zertechleba/minigraf-0507-arduino/docs/img/schema_xy4131_en.jpg

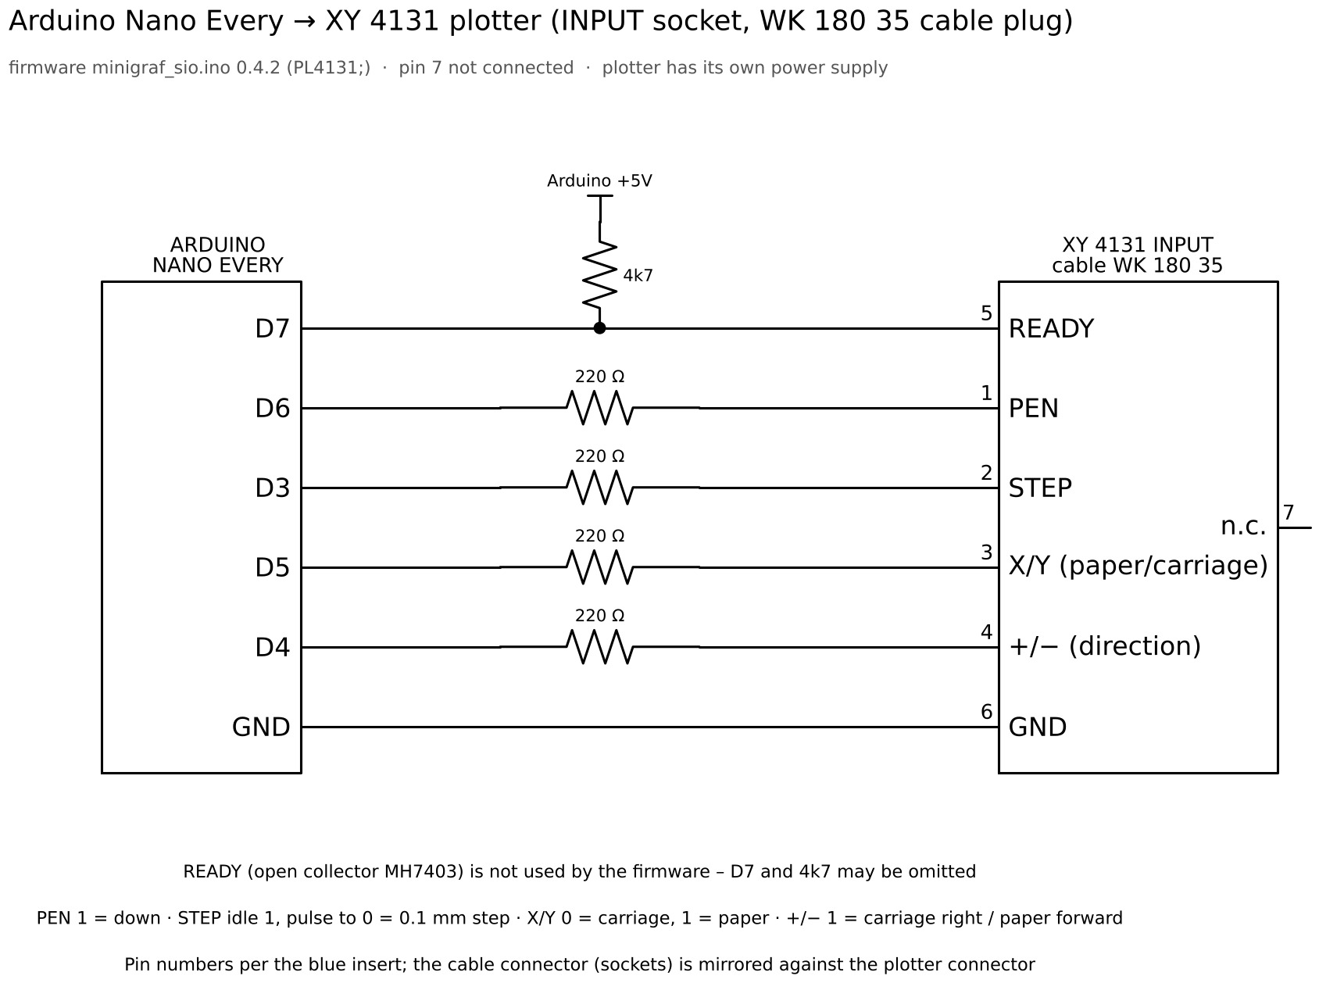
docs/img/schema_xy4131_en.jpg
