zertechleba/minigraf-0507-arduino/pc/hershey_script.py

"""Hersheyho jednotahové psací písmo "cursive" (A. V. Hershey, U.S. National Bureau of Standards, 1967):
písmena psacího písma "scripts", číslice a znaménka jednou čarou.
Data převzata z balíčku HersheyFonts (https://github.com/apshu/HersheyFonts, licence MIT).
Formát: znak -> (levý okraj, pravý okraj, tahy); souřadnice Hershey: y dolů, účaří y = 9,
horní linie velkých písmen y = -12. Převod a diakritiku dělá text_plot.py (--font psane)."""

GLYPHS = {
    ' ': (-8, 8, []),
    '!': (-5, 5, [[(0, -12), (0, 2)], [(0, 7), (-1, 8), (0, 9), (1, 8), (0, 7)]]),
    '"': (-8, 8, [[(-4, -12), (-4, -5)], [(4, -12), (4, -5)]]),
    '#': (-10, 11, [[(1, -16), (-6, 16)], [(7, -16), (0, 16)], [(-6, -3), (8, -3)], [(-7, 3), (7, 3)]]),
    '$': (-10, 10, [[(-2, -16), (-2, 13)], [(2, -16), (2, 13)], [(7, -9), (5, -11), (2, -12), (-2, -12), (-5, -11), (-7, -9), (-7, -7), (-6, -5), (-5, -4), (-3, -3), (3, -1), (5, 0), (6, 1), (7, 3), (7, 6), (5, 8), (2, 9), (-2, 9), (-5, 8), (-7, 6)]]),
    '%': (-12, 12, [[(9, -12), (-9, 9)], [(-4, -12), (-2, -10), (-2, -8), (-3, -6), (-5, -5), (-7, -5), (-9, -7), (-9, -9), (-8, -11), (-6, -12), (-4, -12), (-2, -11), (1, -10), (4, -10), (7, -11), (9, -12)], [(5, 2), (3, 3), (2, 5), (2, 7), (4, 9), (6, 9), (8, 8), (9, 6), (9, 4), (7, 2), (5, 2)]]),
    '&': (-13, 13, [[(10, -3), (10, -4), (9, -5), (8, -5), (7, -4), (6, -2), (4, 3), (2, 6), (0, 8), (-2, 9), (-6, 9), (-8, 8), (-9, 7), (-10, 5), (-10, 3), (-9, 1), (-8, 0), (-1, -4), (0, -5), (1, -7), (1, -9), (0, -11), (-2, -12), (-4, -11), (-5, -9), (-5, -7), (-4, -4), (-2, -1), (3, 6), (5, 8), (7, 9), (9, 9), (10, 8), (10, 7)]]),
    "'": (-2, 2, [[(0, -5), (0, -1)]]),
    '(': (-7, 7, [[(4, -16), (2, -14), (0, -11), (-2, -7), (-3, -2), (-3, 2), (-2, 7), (0, 11), (2, 14), (4, 16)]]),
    ')': (-7, 7, [[(-4, -16), (-2, -14), (0, -11), (2, -7), (3, -2), (3, 2), (2, 7), (0, 11), (-2, 14), (-4, 16)]]),
    '*': (-8, 8, [[(0, -6), (0, 6)], [(-5, -3), (5, 3)], [(5, -3), (-5, 3)]]),
    '+': (-13, 13, [[(0, -9), (0, 9)], [(-9, 0), (9, 0)]]),
    ',': (-4, 4, [[(1, 5), (0, 6), (-1, 5), (0, 4), (1, 5), (1, 7), (-1, 9)]]),
    '-': (-13, 13, [[(-9, 0), (9, 0)]]),
    '.': (-4, 4, [[(0, 4), (-1, 5), (0, 6), (1, 5), (0, 4)]]),
    '/': (-11, 11, [[(9, -16), (-9, 16)]]),
    '0': (-10, 10, [[(-1, -12), (-4, -11), (-6, -8), (-7, -3), (-7, 0), (-6, 5), (-4, 8), (-1, 9), (1, 9), (4, 8), (6, 5), (7, 0), (7, -3), (6, -8), (4, -11), (1, -12), (-1, -12)]]),
    '1': (-10, 10, [[(-4, -8), (-2, -9), (1, -12), (1, 9)]]),
    '2': (-10, 10, [[(-6, -7), (-6, -8), (-5, -10), (-4, -11), (-2, -12), (2, -12), (4, -11), (5, -10), (6, -8), (6, -6), (5, -4), (3, -1), (-7, 9), (7, 9)]]),
    '3': (-10, 10, [[(-5, -12), (6, -12), (0, -4), (3, -4), (5, -3), (6, -2), (7, 1), (7, 3), (6, 6), (4, 8), (1, 9), (-2, 9), (-5, 8), (-6, 7), (-7, 5)]]),
    '4': (-10, 10, [[(3, -12), (-7, 2), (8, 2)], [(3, -12), (3, 9)]]),
    '5': (-10, 10, [[(5, -12), (-5, -12), (-6, -3), (-5, -4), (-2, -5), (1, -5), (4, -4), (6, -2), (7, 1), (7, 3), (6, 6), (4, 8), (1, 9), (-2, 9), (-5, 8), (-6, 7), (-7, 5)]]),
    '6': (-10, 10, [[(6, -9), (5, -11), (2, -12), (0, -12), (-3, -11), (-5, -8), (-6, -3), (-6, 2), (-5, 6), (-3, 8), (0, 9), (1, 9), (4, 8), (6, 6), (7, 3), (7, 2), (6, -1), (4, -3), (1, -4), (0, -4), (-3, -3), (-5, -1), (-6, 2)]]),
    '7': (-10, 10, [[(7, -12), (-3, 9)], [(-7, -12), (7, -12)]]),
    '8': (-10, 10, [[(-2, -12), (-5, -11), (-6, -9), (-6, -7), (-5, -5), (-3, -4), (1, -3), (4, -2), (6, 0), (7, 2), (7, 5), (6, 7), (5, 8), (2, 9), (-2, 9), (-5, 8), (-6, 7), (-7, 5), (-7, 2), (-6, 0), (-4, -2), (-1, -3), (3, -4), (5, -5), (6, -7), (6, -9), (5, -11), (2, -12), (-2, -12)]]),
    '9': (-10, 10, [[(6, -5), (5, -2), (3, 0), (0, 1), (-1, 1), (-4, 0), (-6, -2), (-7, -5), (-7, -6), (-6, -9), (-4, -11), (-1, -12), (0, -12), (3, -11), (5, -9), (6, -5), (6, 0), (5, 5), (3, 8), (0, 9), (-2, 9), (-5, 8), (-6, 6)]]),
    ':': (-4, 4, [[(0, -3), (-1, -2), (0, -1), (1, -2), (0, -3)], [(0, 4), (-1, 5), (0, 6), (1, 5), (0, 4)]]),
    ';': (-4, 4, [[(0, -3), (-1, -2), (0, -1), (1, -2), (0, -3)], [(1, 5), (0, 6), (-1, 5), (0, 4), (1, 5), (1, 7), (-1, 9)]]),
    '<': (-12, 12, [[(8, -9), (-8, 0), (8, 9)]]),
    '=': (-13, 13, [[(-9, -3), (9, -3)], [(-9, 3), (9, 3)]]),
    '>': (-12, 12, [[(-8, -9), (8, 0), (-8, 9)]]),
    '?': (-9, 9, [[(-6, -7), (-6, -8), (-5, -10), (-4, -11), (-2, -12), (2, -12), (4, -11), (5, -10), (6, -8), (6, -6), (5, -4), (4, -3), (0, -1), (0, 2)], [(0, 7), (-1, 8), (0, 9), (1, 8), (0, 7)]]),
    '@': (-13, 14, [[(5, -4), (4, -6), (2, -7), (-1, -7), (-3, -6), (-4, -5), (-5, -2), (-5, 1), (-4, 3), (-2, 4), (1, 4), (3, 3), (4, 1)], [(-1, -7), (-3, -5), (-4, -2), (-4, 1), (-3, 3), (-2, 4)], [(5, -7), (4, 1), (4, 3), (6, 4), (8, 4), (10, 2), (11, -1), (11, -3), (10, -6), (9, -8), (7, -10), (5, -11), (2, -12), (-1, -12), (-4, -11), (-6, -10), (-8, -8), (-9, -6), (-10, -3), (-10, 0), (-9, 3), (-8, 5), (-6, 7), (-4, 8), (-1, 9), (2, 9), (5, 8), (7, 7), (8, 6)], [(6, -7), (5, 1), (5, 3), (6, 4)]]),
    'A': (-11, 9, [[(-11, 9), (-9, 8), (-6, 5), (-3, 1), (1, -6), (4, -12), (4, 9), (3, 6), (1, 3), (-1, 1), (-4, -1), (-6, -1), (-7, 0), (-7, 2), (-6, 4), (-4, 6), (-1, 8), (2, 9), (7, 9)]]),
    'B': (-12, 11, [[(1, -10), (2, -9), (2, -6), (1, -2), (0, 1), (-1, 3), (-3, 6), (-5, 8), (-7, 9), (-8, 9), (-9, 8), (-9, 5), (-8, 0), (-7, -3), (-6, -5), (-4, -8), (-2, -10), (0, -11), (3, -12), (6, -12), (8, -11), (9, -9), (9, -7), (8, -5), (7, -4), (5, -3), (2, -2)], [(1, -2), (2, -2), (5, -1), (6, 0), (7, 2), (7, 5), (6, 7), (5, 8), (3, 9), (0, 9), (-2, 8), (-3, 6)]]),
    'C': (-10, 10, [[(2, -6), (2, -5), (3, -4), (5, -4), (7, -5), (8, -7), (8, -9), (7, -11), (5, -12), (2, -12), (-1, -11), (-3, -9), (-5, -6), (-6, -4), (-7, 0), (-7, 4), (-6, 7), (-5, 8), (-3, 9), (-1, 9), (2, 8), (4, 6), (5, 4)]]),
    'D': (-11, 12, [[(2, -12), (0, -11), (-1, -9), (-2, -5), (-3, 1), (-4, 4), (-5, 6), (-7, 8), (-9, 9), (-11, 9), (-12, 8), (-12, 6), (-11, 5), (-9, 5), (-7, 6), (-5, 8), (-2, 9), (1, 9), (4, 8), (6, 6), (8, 2), (9, -3), (9, -7), (8, -10), (7, -11), (5, -12), (2, -12), (0, -10), (0, -8), (1, -5), (3, -2), (5, 0), (8, 2), (10, 3)]]),
    'E': (-10, 10, [[(4, -8), (4, -7), (5, -6), (7, -6), (8, -7), (8, -9), (7, -11), (4, -12), (0, -12), (-3, -11), (-4, -9), (-4, -6), (-3, -4), (-2, -3), (1, -2), (-2, -2), (-5, -1), (-6, 0), (-7, 2), (-7, 5), (-6, 7), (-5, 8), (-2, 9), (1, 9), (4, 8), (6, 6), (7, 4)]]),
    'F': (-10, 10, [[(0, -6), (-2, -6), (-4, -7), (-5, -9), (-4, -11), (-1, -12), (2, -12), (6, -11), (9, -11), (11, -12)], [(6, -11), (4, -4), (2, 2), (0, 6), (-2, 8), (-4, 9), (-6, 9), (-8, 8), (-9, 6), (-9, 4), (-8, 3), (-6, 3), (-4, 4)], [(-1, -2), (8, -2)]]),
    'G': (-11, 12, [[(-11, 9), (-9, 8), (-5, 4), (-2, -1), (-1, -4), (0, -8), (0, -11), (-1, -12), (-2, -12), (-3, -11), (-4, -9), (-4, -6), (-3, -4), (-1, -3), (3, -3), (6, -4), (7, -5), (8, -7), (8, -1), (7, 4), (6, 6), (4, 8), (1, 9), (-3, 9), (-6, 8), (-8, 6), (-9, 4), (-9, 2)]]),
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
}
