zertechleba/minigraf-0507-arduino/(commit log)

2026-11-07 Minigraf 0507 – ovládání pomocí Arduino Nano Every, verze 0.1
    Firmware pro Arduino Nano Every / Leonardo (emulace Atari SIO tiskárny P1:,
    zjednodušené HPGL), Python nástroje pro PC, PDF návod a schémata.
    Claude-Session: https://claude.ai/code/session_01PmtbAt4mi8LEPh7bWp6Qek
2026-11-08 Verze 0.3: najetí na doraz (HM) a meze plochy (LM)
    - firmware: HM – jízda na levý doraz, X=0, pak startovní pozice X=60;
    absolutní poloha a meze plochy LM uložené v EEPROM (výchozí X 1580);
    IN už nemění fáze motorů (žádný poskok)
    - plot.py, text_plot.py 0.3: HM automaticky před výkresem, --nohome,
    plocha 1520 kroků od startovní pozice
    - návody CZ/EN v0.3, README
    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
2026-11-08 Verze 0.3.5: žádné kaňky při výpadku komunikace
    - firmware 0.3.5: pero dole a 1 s bez příkazu -> automaticky zvednout
    - plot.py 0.3.5: dotaz na Arduino už po 3 s (dřív 20 s)
    - návody CZ/EN v0.3.5, README
    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
2026-11-08 Nová fotka zkušební stránky a vysvětlení kaňky
    Fotka zkušební stránky z verze 0.3.4 v README i v návodech CZ/EN
    (obr. 6) s popisem, proč vznikla kaňka a jak ji řeší verze 0.3.5.
    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
2026-11-08 Verze 0.3.8: osa Y podle založení papíru, okraje A4 10/10/15/15 mm
    - firmware 0.3.8: HM bere založený papír jako Y 0 a jede na start 60,144;
    výchozí meze 1580 x 2284 (změřeno obdélníkem), nové výchozí v EEPROM
    - text_plot.py / plot.py 0.3.8: plocha 1520 x 2140 kroků, --margin 8/5 mm
    - návody CZ/EN v0.3.8 (založení papíru, okraje, souřadnice), README
    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
2026-11-08 Firmware 0.4.1: USB funguje i bez připojeného převodníku SIO
    Při trvale nízkém signálu SIO Command (odpojený převodník) firmware
    čekal jen na Atari, neobsluhoval USB a LED neblikala. Nově to po 0,3 s
    ohlásí a dál obsluhuje USB; D2 má vnitřní pull-up. Návody 0.4.1.
    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
2026-11-08 Verze 0.4.4: přepnutí plotteru z PC (--select, --plotter)
    - plot.py 0.4.4: --select 0507/4131 jen přepne plotter v Arduinu;
    --plotter 0507/4131 v plot.py i text_plot.py plotter rovnou přepne
    - návody CZ/EN 0.4.4: tři způsoby přepnutí (monitor, PC, Atari),
    ukázka výběru plotteru v Atari BASICu; firmware beze změny (0.4.2)
    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
2026-11-09 Návody 0.5.3: kapitola Doplňkové programy – fraktály
    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
2026-11-09 Verze 0.5.11: mzxr_tap.py – tisk obrázků ZX Spectrum/MZXR ze souboru .tap
    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
2026-11-09 Verze 0.5.12: hpgl2atari.py – výkresy pro Atari BASIC + disketa ATR
    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
